Anuroop220/XonFrame/README.md

# XonFrame
XonFrame is an open-source smart glasses powered using ESP32-S3 and web app named XOSOFTWARE running E.L.I.X (The AI assistant for XonFrame)
My goal is to build smart glasses that are affordable and completely open source

They are open source and apparently they are smart too !

## Features

- Real time Navigation

- Live Camera feed

- Object detection

- Phone notifications

- Reminders

And we can talk to ELIX

The glasses mainly collect information and display results.

The phone handles speech recognition, computer vision, reasoning, navigation, and other AI features.

## HOW IT WORKS
The camera in the glasses capture frames when told and send it to xosoftware via wifi and ELIX looks at it and the question and answers the question !

## SCHEMATICS

SCH_Schematic1_1-P1_2026-08-31

## 3D MODELS

                                         THIS IS THE CHARGING POD WERE THE TP4056 WILL BE THERE


                                              THIS IS HOW THE GLASSES WILL LOOK LIKE  


## PCB DESIGN

                                              THIS IS THE PCB DESIGN FOR THIS PROJECT
PCB_PCB1_2026-08-31 (1)

PCB_PCB1_2026-08-31 (2)

## BOM

| SL  NO | COMPONENT | QTY | VALUE  | PRICE | BUYING LINKS |
| :---: | :---: | :---: | :---: | :---: | :---: |
| 1 | ESP32-S3FH4R2 | 1 | - | $ 3.47  | [ESP32](https://www.lcsc.com/product-detail/C3013940.html?s_z=n_q_C3013940&globalKeyword=C3013940) |
| 2 | FPC CONNECTOR | 1 | - | $ 1.94  | [FPCCONNECTOR](https://www.lcsc.com/product-detail/C718080.html?s\_z=n\_q\_C718080\&globalKeyword=C718080) |
| 3 | 2.2nH INDUCTOR | 1 | 2.2nH | $ 0.03  | [INDUCTOR](https://www.lcsc.com/product-detail/C2044175.html?s_z=n_q_C2044175&globalKeyword=C2044175) |
| 4 | UFL CONNECTOR | 1 | - | $ 0.51  | [UFLCONNECTOR](https://www.lcsc.com/product-detail/C88374.html?s_z=n_q_C88374&globalKeyword=C88374) |
| 5 | 100uF | 1 | 100uF | $ 0.75  | [100uFCAPACITOR](https://www.lcsc.com/product-detail/C6882730.html?s_z=n_q_C6882730&globalKeyword=C6882730) |
| 6 | 1pF CAPCITOR | 2 | 1pF | ~ $0.0069  ($0.69 / 100 pcs)  | [1pFCAPACITOR](https://www.lcsc.com/product-detail/C277493.html?s_z=n_q_C277493&globalKeyword=C277493) |
| 7 | 100nF CAPACITOR | 8 | 100nF | ~ $0.0055 ($0.55 / 100 pcs)  | [100nFCAPACITOR](https://www.lcsc.com/product-detail/C1525.html?globalKeyword=C1525&s_z=n_q_C1525)  |
| 8 | 10uF CAPACITOR | 2 | 10uF | ~ $0.0258 ($2.58 / 100 pcs)  | [10uFCAPACITOR](https://www.lcsc.com/product-detail/C15525.html?s_z=n_q_C15525&globalKeyword=C15525) |
| 9 | 5.1kΩ RESISTOR | 2 | 5.1kΩ | ~ $ 0.0026 ($0.26 / 100 pcs) | [5.1kΩRESISTOR](https://www.lcsc.com/product-detail/C25905.html?s_z=n_q_C25905&globalKeyword=C25905)  |
| 10 | 4.7kΩ RESISTOR | 2 | 4.7kΩ | ~ $ 0.0029 ($0.29 / 100 pcs) | [4.7kΩRESISTOR](https://www.lcsc.com/product-detail/C25900.html?s_z=n_q_C25900&globalKeyword=C25900) |
| 11 | 10kΩ RESISTOR | 3 | 10kΩ | ~ $ 0.0031 ($0.31 / 100 pcs) | [10kΩRESISTOR](https://www.lcsc.com/product-detail/C25744.html?s_z=n_q_C25744&globalKeyword=C25744) |
| 12 | AP2112K-3.3TRG1 3.3V LDO REGULATOR  | 1 | - | ~ $ 0.1777 ($0.89  / 5 pcs) | [3.3VLDO](https://www.lcsc.com/product-detail/C51118.html?s_z=n_q_C51118&globalKeyword=C51118)  |
| 13 | TYPE-C-31-M-12 16-PIN USB-C RECEPTACLE | 1 | - | ~ $ 0.1716 ($0.86 / 5 pcs) | [USB-C](https://www.lcsc.com/product-detail/C165948.html?s_z=n_q_C165948&globalKeyword=C165948)  |
| 14 | USBLC6-2SC6 ESD PROTECTION DIODE ARRAY  | 1 | - | ~ $ 0.0449 ($0.45 / 10 pcs) | [USBLC6-2SC6](https://www.lcsc.com/product-detail/C2827654.html?s_z=n_q_C2827654&globalKeyword=C2827654)  |
| 15 | TS-1187A-B-A-B 5.1x5.1mm SMD TACTILE SWITCH  | 2 | - | ~ $ 0.0186 ($ 0.37 / 20 pcs) | [SMDSWITCH](https://www.lcsc.com/product-detail/C318884.html?s_z=n_q_C318884&globalKeyword=C318884) |
| 16 | BOSCH BMI270 IMU | 1 | - | $ 3.22  | [IMU](https://www.lcsc.com/product-detail/C2836813.html?s_z=n_q_C2836813&globalKeyword=C2836813)  |
| 17 | 2.54mm PITCH 1X2 MALE PIN HEADER  (ONE FOR CONNECTING THE BATTERY’S \+VE AND \- VE & THE OTHER ONE FOR CONNECTING THE AMPLIFIER BREAKOUT BOARD’S SPEAKER OUTPUT) | 2 | - | ~ $ 0.0299 ($0.60 / 20 pcs) | [1X2HEADERS](https://www.lcsc.com/product-detail/C124375.html?s_z=n_q_C124375&globalKeyword=C124375) |
| 18 | 2.54mm PITCH 1X3 MALE PIN HEADER  (BOTH ARE USED IN PLACE OF THE THE MIC’S PINS BECAUSE WE ARE USING INMP441 BREAKOUT BOARD) | 2 | - | ~ $ 0.0239 ($0.48 / 20 pcs)  | [1X3HEADERS](https://www.lcsc.com/product-detail/C52016391.html?s_z=n_q_C52016391&globalKeyword=C52016391) |
| 19 | 2.54mm PITCH 1X7 MALE PIN HEADER  (THIS IS USED AS IN PLACE OF THE AMPLIFIER’S 7 PINS) | 1 | - | ~ $ 0.0399 ($0.40 / 10 pcs)  | [1X7HEADERS](https://www.lcsc.com/product-detail/C5360900.html?s_z=n_q_C5360900&globalKeyword=C5360900) |
| 20 | 2.54mm PITCH 1X4 MALE PIN HEADER  (THIS IS USED AS IN PLACE OF THE DISPLAY’S 4 PINS) | 1 | - | ~ $ 0.0211 ($0.42 / 20 pcs) | [1X4HEADERS](http://lcsc.com/product-detail/C5116483.html?s_z=n_q_C5116483&globalKeyword=C5116483) |

--- 

> [!NOTE]
> COMPONENTS TO BE BOUGHT SEPARATELY ARE GIVEN BELOW *(BREAKOUT BOARDS,BATTERIES ETC)*                     

| | | |  | | |
| :---: | ----- | :---: | :---: | :---: | ----- |
| **SL NO** | **COMPONENT** | **QTY** | **VALUE** | **PRICE** | **BUYING LINKS** |
| 1 | INMP441 MEMS 12S MIC  | 1 | - | $ 3.13 | [INMP441MIC](https://www.amazon.in/DELLZO-INMP441-Digital-Microphone-Module/dp/B0GWM67TGW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)  |
| 2 | MAX98357 I2S 3W Class D Amplifier  | 1 | - | $ 2.87 | [MAX98357](https://www.amazon.in/MAX98357-Amplifier-Interface-Filterless-Raspberry/dp/B08XJSV2BH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) |
| 3 | Waveshare 0.49inch 64×32 OLED Display | 1 | - | $ 5.96 | [0.49INDISPLAY](https://robu.in/product/waveshare-0-49inch-oled-display-module-64x32-resolution-i2c-communication-black-white-display-color)  |
| 4 | 3.7V 450mAh Li-Po Rechargeable Battery (501035)  | 2 | - | $4.08 | [3.7VBATTERY](https://www.amazon.in/Rechargeable-501035-Lightweight-Earphones-Electroglobal/dp/B0G8G7PCJS?th=1) |
| 5 | GSM FPC (Flexible) Antenna -1.5 dBi with UFL (IPEX) Connector  | 1 | - | ~ $ 0.60 | [PIGTAILANTENNA](https://evelta.com/gsm-fpc-flexible-antenna-1-5-dbi-with-ufl-ipex-connector) |
| 6 | OV5640 Camera Module 5MP 68° HFOV MIPI 24-pin FPC  | 1 | - | $ 9.42 | [OV5640CAMERA](https://www.amazon.in/dp/B0HCYQJ8L3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) |
| 7 | TP4056 C TYPE Charging Module  | 1 | - | $ 0.68 | [TP4056](https://www.amazon.in/UNIVERSAL-HUB-TP4056-Overcharge-Protection/dp/B0FVLYQBKC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) |
| 8 | Exciter 8Ω 1W Bone conduction speaker  | 1 | - | ~ $7.43  | [SPEAKER](https://www.thingbits.in/products/bone-conductor-transducer-with-wires-8-ohm-1-watt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) |

# TUTORIAL ON BUILDING !

 ## SECTION 1 - 🛠️*HARDWARE PART*
  
### STEP 1
---
**Download XonFrame Repository**
Clone or download the repository.

Folders/Files -

 3D MODELS/
 
 BOM/
 
 Firmware/
 
 Pcb/
 
 Software/
 
 README.md

### STEP 2 
---
#### Order the PCB

Go to the PCB folder

You will find the GERBER ZIP and much more

And in BOM folder you will find the BOM file

After getting this files

Go to [JLCPCB](https://jlcpcb.com/)

Click **"Order now"**



Then upload the provided XonFrame_Gerbers.zip here



##### PCB Settings

For this pcb use this settings 









##### PCB Assembly

While Ordering the pcb just turn on the Pcb Assembly option



AFTER THAT -


**CLICK NEXT** 
THEN-  YOU WILL BE IN DIRECTED TO THIS PAGE 



AND IN HERE **CLICK THIS** 



AND UPLOAD THE BOM AND CPL FILES PROVIDED IN THE BOM FOLDER IN HERE



NEXT YOU WILL GET TO THIS PAGE AND THEN MAKE SURE EVERY COMPONENT IS SELECTED OR JUST CLICK SELECT ALL IT IS MARKED IN THE PIC BELOW


 
THEN IN THE FOLLOWING PAGE CLICK **ADD TO CART AND AFTER THAT BUY IT**

### STEP 3
---
 #### 3D Printing the Frame

Go to 3D MODELS/

Then Upload the STL files.

***(Do not resize them)***

Set the model Scale to 100%

#### *Settings to use*

| Material | PETG |
| :---- | :---- |
| Layer height | 0.16 \- 0.20 mm |
| walls | 3 |
| infill | 15 \- 25 % |
| nozzle | 0.4mm |
| Support  | Only when needed |

   ## SECTION 2 👨‍💻*SOFTWARE PART*
 
### STEP 1

---

#### Installing Arduino IDE 
Install Arduino IDE  from [INSTALL ARDUINO IDE](https://www.arduino.cc/en/software/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.)
Then install the ESP32 board package 
File - Preferences - and in additional board manager urls 
PASTE THIS 
> ```
> https://espressif.github.io/arduino-esp32/package_esp32_index.json
>  ```



AFTER THAT -
Search  **ESP32**  in the Boards Manager tab 



and install 
**esp32 by espressif systems**



<br><br>

***Arduino IDE Board Configuration***

---

> [!IMPORTANT]
> ESP32-S3FH4R2 is a bare chip, not a devkit so we need to change the default configuration for that  first select the board
Search  ESP32S3 dev module select ESP32S3 Dev Module (we should not select the Octal (WROOM2) one  we should select the normal one) 
Then in Tools menu Scroll down  Then use these configurations -

---


After that 
Select the COM port 

Tools - Port

### STEP 2
---
#### 📚Arduino IDE Libraries
---

THESE ARE THE 3 LIBRARIES TO BE INSTALLED  (*DEPENDENCIES OF THESE SHOULD BE INSTALLED TOO*)





Now for Configuring wifi 

Replace this part with your wifi name and password

> #define WIFI_SSID "YOUR_WIFI"

> #define WIFI_PASSWORD "YOUR_PASSWORD"

And changing **click upload** and it will be flashed into the ESP32

### STEP 3
---
#### 🤖ELIX

---
For using ELIX we need python so

First install [Python](https://www.python.org/downloads) (*latest version*)

Now Go to the folder path in the terminal

using  the command    

cd <pastethepathtothefolder> 

Now for installing the dependences 

Type  -   
```
pip install requirements.txt
```

### STEP 4
---
#### 🔑API KEYS 

---
API keys are needed for the maps,messages and elix

So

FIRST GET THE API KEYS FROM THE FOLLOWING SERVICES

GEMINI API - [GOOGLEAISTUDIO](https://aistudio.google.com)

ORS API - [OPENROUTESERVICE](https://openrouteservice.org)

PUSHBULLET API - [PUSHBULLET API](https://www.pushbullet.com)

After getting the keys we need to put them in the .env file

The repo already has a file called

##### .env.example

First copy the contents in that file and then make a new txt file in the software folder that And paste the contents of .env.example.  

> [!WARNING]
> Do not commit your personal API keys or `.env` files to a public repository!

NEXT fill the empty spaces with API and save it 

>[!TIP]
>Eg - GEMINI_API_KEY=  APIKEY12345

>[!IMPORTANT]
>And after saving the rename the file to .env

### STEP 5 (Last Step)
---
#### FOR TESTING ELIX (laptop) 

---
 To test **ELIX** keep elix_bridge.py running while using the xosoftware and main.py

start it in another terminal by typing python elix_bridge.py 

First go to to the Repository/folder path and Type 
```
python main.py
```
in the first window 

***Next*** create a Second terminal window (*Make sure it is in the correct folder path*) and Type
```
python elix_bridge.py
```

>[!NOTE]
>Both should be running along side the xosoftware in the browser

use this bridge URL in the xosoftware settings tab
http://<paste_laptop_ip_here>:5001

if it is running in the same computer where the xosofware is running 

use this IP
``` 
http://localhost:5001
```

 it will be already there so no need to change

## Contributing

If you have ideas, find a bug, or want to help building XonFrame, feel free to open an issue or submit a pull request.

Whether it's firmware, hardware, documentation, or design every contributions are welcome

## License

Software is licensed under Apache 2.0.

Hardware designs are licensed under CERN-OHL-W-2.0.

by Anuroop
