Anuroop220/XonFrame/3D MODELS/FRAME FULL.step

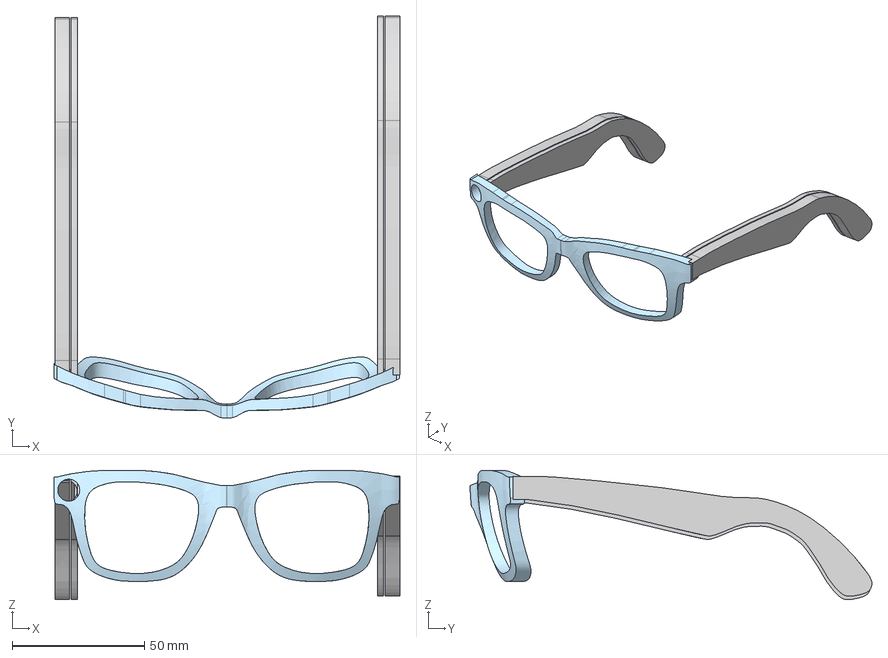
[picture p1: CAD file, 2026-08-31]
3D MODELS/FRAME FULL.step
130.6 x 151.8 x 48.8 mm
