Anuroop220/XonFrame/3D MODELS/CHARGE POD FULL.step

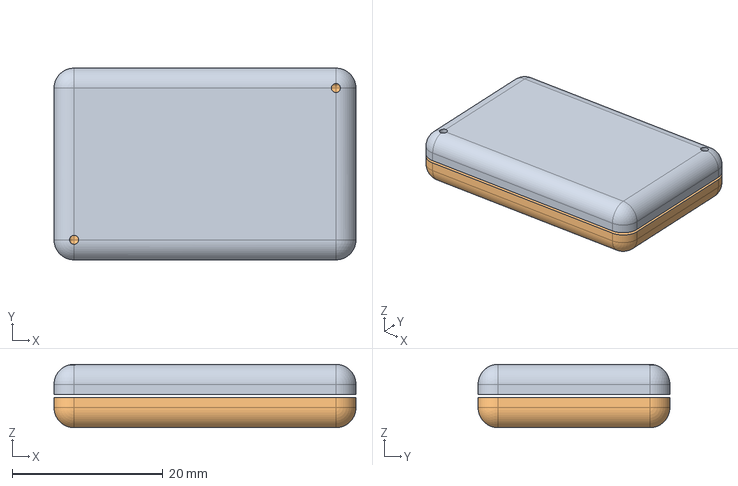
[picture p2: CAD file, 2026-08-31]
3D MODELS/CHARGE POD FULL.step
40.0 x 25.4 x 8.40 mm
