Anuroop220/XonFrame/3D MODELS/FRAME left leg 2.step

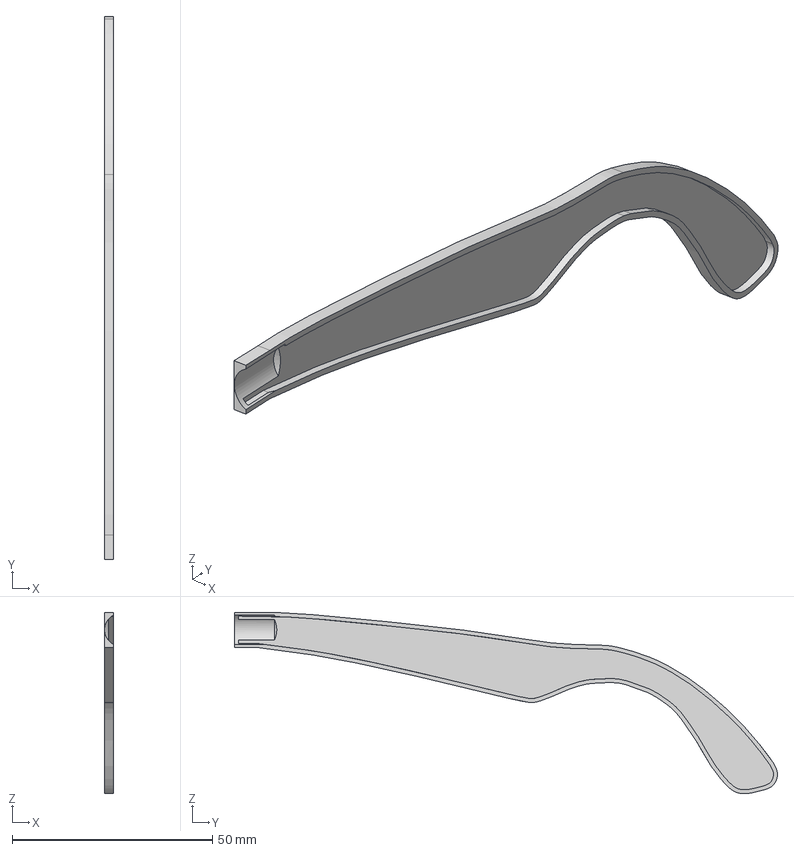
[picture p4: CAD file, 2026-08-31]
3D MODELS/FRAME left leg 2.step
2.35 x 135.6 x 45.3 mm
