Anuroop220/XonFrame/3D MODELS/STL/ALL IN ONE FRAME.stl

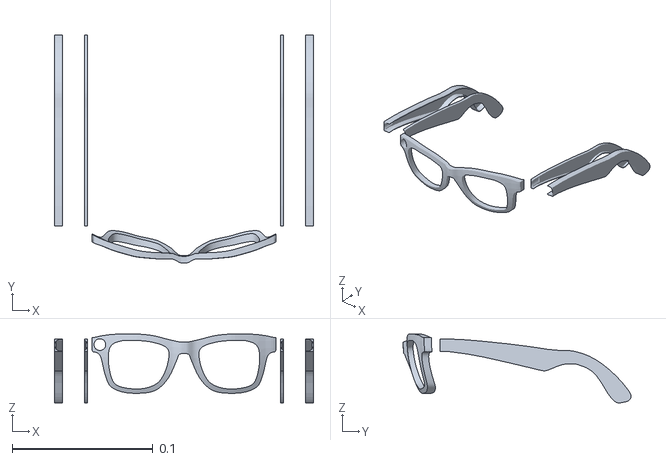
[picture p5: CAD file, 2026-08-12]
3D MODELS/STL/ALL IN ONE FRAME.stl
0.184 x 0.162 x 0.0488
