Anuroop220/XonFrame/3D MODELS/FRAME FRONT.step

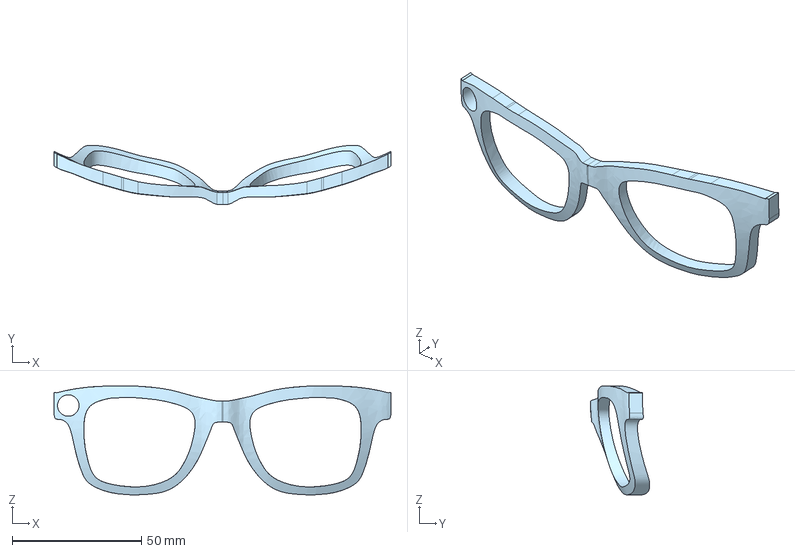
[picture p6: CAD file, 2026-08-31]
3D MODELS/FRAME FRONT.step
130.4 x 23.0 x 42.0 mm
