Anuroop220/XonFrame/3D MODELS/STL/CHARGE POD BOTTOM.stl

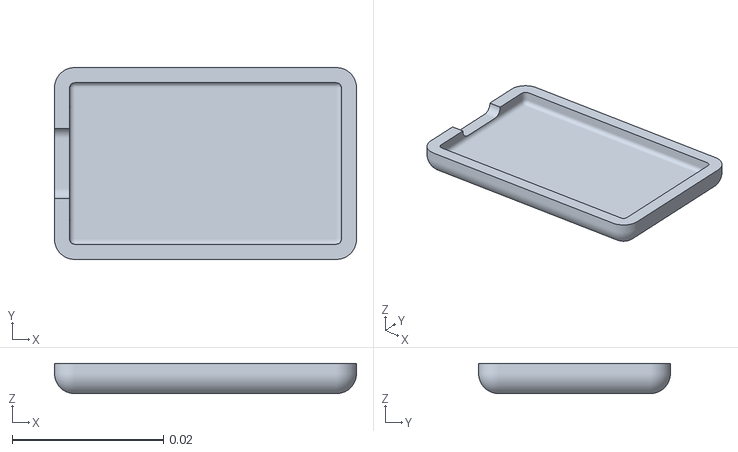
[picture p8: CAD file, 2026-08-12]
3D MODELS/STL/CHARGE POD BOTTOM.stl
0.04 x 0.0254 x 0.004
