Anuroop220/XonFrame/3D MODELS/frame leg right 1.step

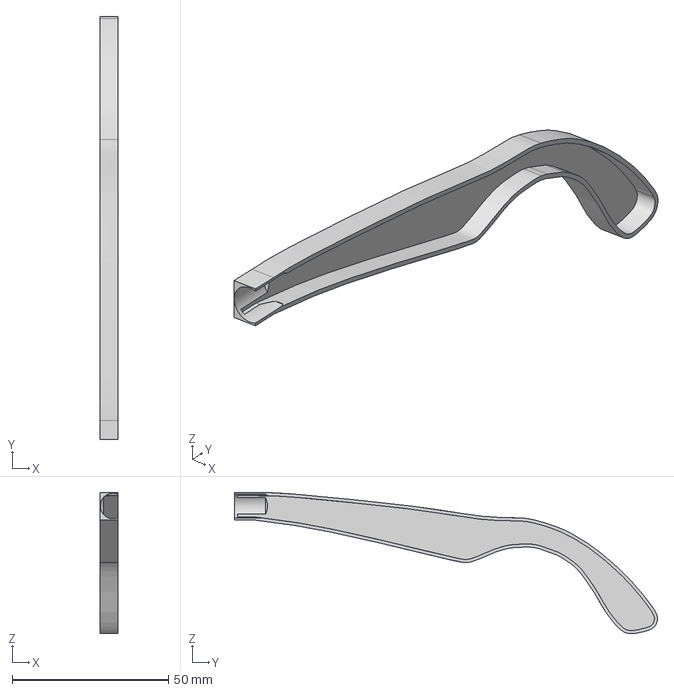
[picture p9: CAD file, 2026-08-31]
3D MODELS/frame leg right 1.step
5.65 x 135.6 x 45.3 mm
