Anuroop220/XonFrame/3D MODELS/STL/FRAME RIGHT LEGS.stl

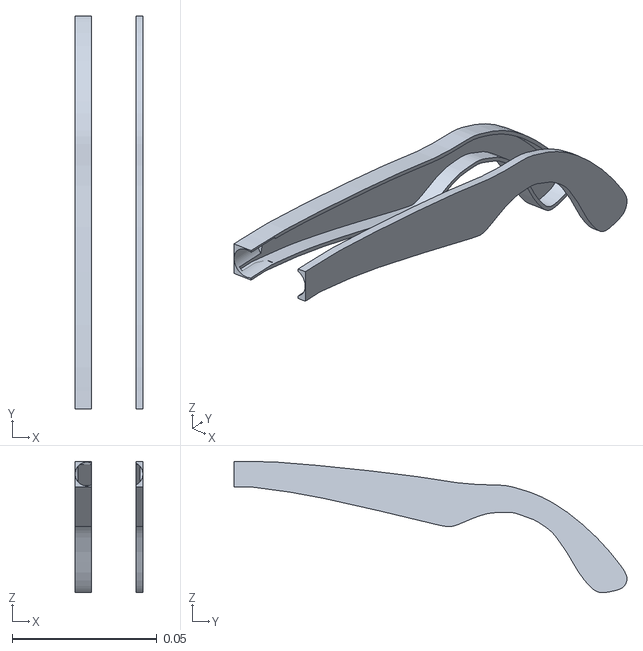
[picture p10: CAD file, 2026-08-12]
3D MODELS/STL/FRAME RIGHT LEGS.stl
0.0235 x 0.136 x 0.0453
