Anuroop220/XonFrame/3D MODELS/CARGE POD BOTTOM.step

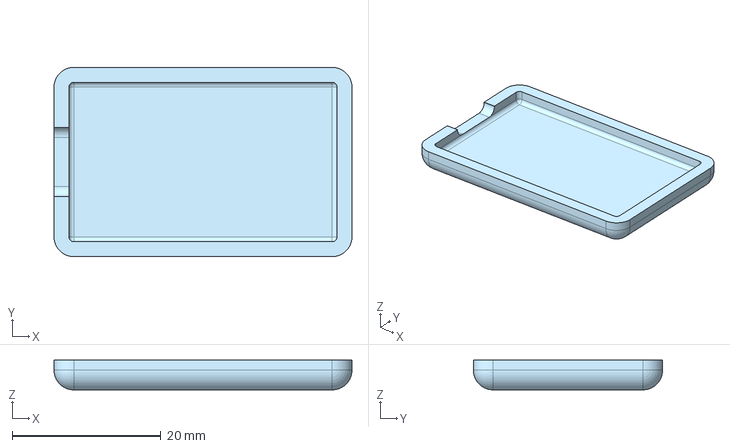
[picture p11: CAD file, 2026-08-31]
3D MODELS/CARGE POD BOTTOM.step
40.0 x 25.4 x 4.00 mm
