Anuroop220/XonFrame/(list of files, cad)

Other CAD files:
3D MODELS/Frame right leg 2.step
3D MODELS/FRAME left leg 1.step
3D MODELS/CHARGE POD TOP.step
3D MODELS/STL/CHARGE POD TOP.stl
3D MODELS/STL/FRAME FRONT.stl
