Anuroop220/XonFrame/Firmware/xonframe/display_assets.h

// display_assets.h
// SSD1306 dashboard bitmaps — extracted from your Lopaka export.
//
// MISSING: image_Weather_bitmap_pixels and image_border_pixels were
// referenced by drawDashboard_Design() but were not present in the export
// you pasted. Re-export them from Lopaka and paste the arrays in below —
// until then the weather icon and the outer border just won't draw (the
// rest of the dashboard renders fine without them).

#pragma once
#include <Arduino.h>
#include <pgmspace.h>

static const unsigned char PROGMEM image_Battery_indicator_bits[] = {0x7f,0xfc,0x80,0x02,0xb6,0xda,0xb6,0xda,0xb6,0xda,0x80,0x02,0x7f,0xfc};
static const unsigned char PROGMEM image_BT_indicator_bits[] = {0x98,0x54,0x36,0x1c,0x36,0x54,0x98};
static const unsigned char PROGMEM image_colon_bits[] = {0x60,0xf0,0xf0,0x60,0x00,0x00,0x00,0x00,0x00,0x00,0x00,0x00,0x00,0x00,0x00,0x00,0x00,0x60,0xf0,0xf0,0x60};
static const unsigned char PROGMEM image_current_days_bits[] = {0xfa,0x2f,0x80,0x22,0x28,0x00,0x22,0x2e,0x00,0x22,0x28,0x00,0x23,0xef,0x80};
static const unsigned char PROGMEM image_Date_day_bits[] = {0xfb,0x80,0x88,0x80,0x88,0x80,0x88,0x80,0xfb,0xe0};
static const unsigned char PROGMEM image_Date_Month_bits[] = {0x0a,0x28,0x80,0x0a,0x2c,0x80,0x0a,0x2a,0x80,0x8a,0x29,0x80,0xfb,0xe8,0x80};
static const unsigned char PROGMEM image_Humidity_indicator_bits[] = {0x63,0x30,0x00,0x94,0xb3,0x00,0x94,0x84,0x80,0x23,0x84,0x00,0x40,0x84,0x00,0x80,0x84,0x80,0xf7,0x03,0x00};
static const unsigned char PROGMEM image_Loc_province_bits[] = {0xf2,0x28,0x00,0x8a,0x28,0x00,0xf2,0x28,0x00,0x8a,0x28,0x00,0xf1,0xcf,0x80};
static const unsigned char PROGMEM image_Nation_bits[] = {0xf2,0x2f,0x80,0x8a,0x22,0x00,0xf3,0xe2,0x00,0x82,0x22,0x00,0x82,0x2f,0x80};
static const unsigned char PROGMEM image_Rain_indicator_bits[] = {0x63,0x00,0x00,0x94,0x98,0x80,0x14,0x99,0x00,0x23,0x82,0x00,0x10,0x84,0x00,0x90,0x89,0x80,0x67,0x11,0x80};
static const unsigned char PROGMEM image_segment_1_bits[] = {0x7f,0xfc,0xbf,0xfa,0xdf,0xf6,0xe0,0x0e,0xe0,0x0e,0xe0,0x0e,0xe0,0x0e,0xe0,0x0e,0xe0,0x0e,0xe0,0x0e,0xe0,0x0e,0xe0,0x0e,0xc0,0x06,0x80,0x02,0x00,0x00,0x80,0x02,0xc0,0x06,0xe0,0x0e,0xe0,0x0e,0xe0,0x0e,0xe0,0x0e,0xe0,0x0e,0xe0,0x0e,0xe0,0x0e,0xe0,0x0e,0xe0,0x0e,0xdf,0xf6,0xbf,0xfa,0x7f,0xfc};
static const unsigned char PROGMEM image_segment_2_bits[] = {0x7f,0xfc,0xbf,0xfa,0xdf,0xf6,0xe0,0x0e,0xe0,0x0e,0xe0,0x0e,0xe0,0x0e,0xe0,0x0e,0xe0,0x0e,0xe0,0x0e,0xe0,0x0e,0xe0,0x0e,0xc0,0x06,0xbf,0xfa,0x7f,0xfc,0x3f,0xfa,0x00,0x06,0x00,0x0e,0x00,0x0e,0x00,0x0e,0x00,0x0e,0x00,0x0e,0x00,0x0e,0x00,0x0e,0x00,0x0e,0x00,0x0e,0x1f,0xf6,0x3f,0xfa,0x7f,0xfc};
static const unsigned char PROGMEM image_segment_3_bits[] = {0x7f,0xfc,0xbf,0xf8,0xdf,0xf0,0xe0,0x00,0xe0,0x00,0xe0,0x00,0xe0,0x00,0xe0,0x00,0xe0,0x00,0xe0,0x00,0xe0,0x00,0xe0,0x00,0xc0,0x00,0xbf,0xf8,0x7f,0xfc,0x3f,0xfa,0x00,0x06,0x00,0x0e,0x00,0x0e,0x00,0x0e,0x00,0x0e,0x00,0x0e,0x00,0x0e,0x00,0x0e,0x00,0x0e,0x00,0x0e,0x1f,0xf6,0x3f,0xfa,0x7f,0xfc};
static const unsigned char PROGMEM image_segment_4_bits[] = {0x20,0x60,0xe0,0xe0,0xe0,0xe0,0xe0,0xe0,0xe0,0xe0,0xe0,0x60,0x20,0x00,0x20,0x60,0xe0,0xe0,0xe0,0xe0,0xe0,0xe0,0xe0,0xe0,0xe0,0x60,0x20};
static const unsigned char PROGMEM image_Temp_bitmap_bits[] = {0x18,0x90,0x25,0x20,0x24,0x90,0x24,0x48,0x24,0x48,0x24,0x90,0x25,0x20,0x24,0x40,0x42,0x08,0x99,0x2a,0xbd,0x1c,0xbd,0x77,0x99,0x1c,0x42,0x2a,0x3c,0x08};
static const unsigned char PROGMEM image_Wifi_indicator_bits[] = {0x3c,0x42,0x99,0x24,0x42,0x18,0x24};

// TODO — paste these two in from a fresh Lopaka export:
// static const unsigned char PROGMEM image_Weather_bitmap_pixels[] = { ... };
// static const unsigned char PROGMEM image_border_pixels[] = { ... };
