Anuroop220/XonFrame/(commit log)

2026-08-12 Update: describe your changes here
    [ALL IN ONE FRAME.stl, CHARGE POD BOTH COMBINED.stl, CHARGE POD BOTTOM.stl, CHARGE POD TOP.stl, FRAME FRONT.stl, FRAME LEFT LEG.stl, FRAME RIGHT LEGS.stl]
2026-08-13 Add Pcb folder
    [BOM_XonFrame.csv]
2026-08-17 Update README with Mouser link for ESP32-S3FH4R2
    Added a link to the ESP32-S3FH4R2 product page on Mouser.
2026-08-31 Add untracked files
    [BOM_XonFrame.csv, PickAndPlace_PCB1_2026_08_30.xlsx]
2026-08-31 Update 3D models: replace STL files with STEP format
    [ALL IN ONE FRAME.stl, CARGE POD BOTTOM.step, CHARGE POD BOTH COMBINED.stl, CHARGE POD BOTTOM.stl, CHARGE POD FULL.step, CHARGE POD TOP.step, CHARGE POD TOP.stl, FRAME FRONT.step]
2026-10-30 Fix formatting of PCB design section in README
2026-10-30 Fix link formatting for ESP32 component in README
2026-10-30 Fix link formatting in BOM section of README
2026-10-30 Fix markdown formatting in BOM section
2026-10-30 Correct link formatting in BOM section
    Fixed markdown link formatting for ESP32 component.
2026-11-01 Clarify download and installation instructions in README
    Updated README to clarify repository download instructions and Arduino IDE installation steps.
2026-11-01 Update README with Arduino IDE installation steps
    Added instructions for installing Arduino IDE and libraries.
2026-11-01 Update README with Arduino IDE installation steps
    Added instructions for installing Arduino IDE and ESP32 board package.
2026-11-01 Revise Arduino IDE setup and library installation steps
    Updated installation instructions for Arduino IDE and added library dependencies.
2026-11-01 Fix formatting in README for Arduino IDE Libraries
